ieb/autopilot/docs/model_architecture_evaluation.md

# Model Architecture Evaluation (Archived)

> **Archived**: This document contains early exploratory notes on a smaller model (48k params, 25 features) that failed in closed-loop testing. The current production system uses a 255k parameter model with 22 features, residual labels, and blended PD + ML inference. See **[blended_pd_ml_controller.md](blended_pd_ml_controller.md)** for the current architecture and validated results.

---

*Historical notes below:*

# Asked Google AI

WDYT about ....
━━━━━━━━━━━━━━━━━━━━━━━━━━━━━━━━━━━━━━┳━━━━━━━━━━━━━━━━━━━━━━━━━━━━━┳━━━━━━━━━━━━━━━━━┓
┃ Layer (type)                         ┃ Output Shape                ┃         Param # ┃
┡━━━━━━━━━━━━━━━━━━━━━━━━━━━━━━━━━━━━━━╇━━━━━━━━━━━━━━━━━━━━━━━━━━━━━╇━━━━━━━━━━━━━━━━━┩
│ sensor_sequence (InputLayer)         │ (None, 20, 25)              │               0 │
├──────────────────────────────────────┼─────────────────────────────┼─────────────────┤
│ feature_mixing (TimeDistributed)     │ (None, 20, 64)              │           1,664 │
├──────────────────────────────────────┼─────────────────────────────┼─────────────────┤
│ bn_feature (TimeDistributed)         │ (None, 20, 64)              │             256 │
├──────────────────────────────────────┼─────────────────────────────┼─────────────────┤
│ lstm_1 (LSTM)                        │ (None, 20, 64)              │          33,024 │
├──────────────────────────────────────┼─────────────────────────────┼─────────────────┤
│ dropout (Dropout)                    │ (None, 20, 64)              │               0 │
├──────────────────────────────────────┼─────────────────────────────┼─────────────────┤
│ lstm_2 (LSTM)                        │ (None, 32)                  │          12,416 │
├──────────────────────────────────────┼─────────────────────────────┼─────────────────┤
│ dropout_1 (Dropout)                  │ (None, 32)                  │               0 │
├──────────────────────────────────────┼─────────────────────────────┼─────────────────┤
│ dense_out (Dense)                    │ (None, 16)                  │             528 │
├──────────────────────────────────────┼─────────────────────────────┼─────────────────┤
│ bn_dense (BatchNormalization)        │ (None, 16)                  │              64 │
├──────────────────────────────────────┼─────────────────────────────┼─────────────────┤
│ rudder_command (Dense)               │ (None, 1)                   │              17 │
└──────────────────────────────────────┴─────────────────────────────┴─────────────────┘
 Total params: 47,969 (187.38 KB)
 Trainable params: 47,809 (186.75 KB)
 Non-trainable params: 160 (640.00 B)

INFO:__main__:Training on 539904 samples, validating on 134976

# Response was 

This model architecture is better structured than your initial attempts, especially for handling sequential sensor data. However, there is one significant bottleneck and a few refinement opportunities for 2026-era training.

1. The Output Layer "Squeeze" (Potential Issue)
The Issue: Your architecture flows from dense_out (16 units) → bn_dense → rudder_command (1 unit).

The Problem: You are applying Batch Normalization directly before your final regression output. In regression tasks, BN can sometimes "fight" the final output layer by forcing the distribution of the 16 hidden neurons to have a mean of 0 and variance of 1 right before you need to predict a specific, un-normalized value (like an angle in degrees).

Recommendation: If you find the model struggling to reach the exact values (e.g., sticking near 0°), move bn_dense to before the dense_out layer or remove it entirely. Batch Normalization is generally most effective deep in the network, not at the final exit. 

2. Feature Mixing Efficiency

The Setup: Using TimeDistributed(Dense(64)) before the LSTM is an excellent design pattern for "feature mixing" (combining 25 sensor inputs into 64 higher-level concepts per timestep).

Optimization: Since you have a large dataset (540k samples), you could likely increase the feature_mixing units to 128 or 256. With 25 input features, 64 is a safe starting point, but the model has enough data to learn more complex relationships. 

3. LSTM Bottleneck

The Setup: lstm_1 (64 units) → lstm_2 (32 units).
The Observation: You are aggressively shrinking the data representation from 64 to 32 units in the second LSTM.

Refinement: If the model's accuracy (MAE) plateaus, consider making lstm_2 larger (64 units) to match lstm_1. Usually, you only shrink the layer size if you are fighting severe overfitting. 

4. Dropout Placement

Best Practice: In 2026, it is widely recommended to place Dropout after the activation but before the next layer. Your current placement after the LSTMs is standard and correct.

Check: Ensure you are using recurrent_dropout inside the LSTM layers if you have long-term temporal dependencies you want to regularize specifically. 

Summary Checklist
Monitor the Final BN: If training is slow to converge on the final degree value, disable bn_dense.

Learning Rate: Given your previous experience, start this run at 1e-4 and use the same ReduceLROnPlateau strategy you perfected earlier.

Trainability: 47,969 parameters for 540,000 samples is a very "lean" model. It is highly unlikely to overfit, so you may eventually find you can afford to double the layer sizes (e.g., 128 → 64 units) if the error isn't low enough. 

# Asked for clarification on "lean"

# Got

In machine learning, the relationship between the number of parameters (the model's "brain" size) and the number of samples (the amount of "experience" it has) determines how well the model learns.
Here is the significance of your "lean" model:
1. High "Data-to-Parameter" Ratio
You have 540,000 samples but only 48,000 parameters. This means the model has roughly 11 samples of information to help it decide the value of every 1 single parameter.

The Benefit: This makes the model very "honest." Because it has so little "brain space" compared to the massive amount of data, it cannot afford to "memorize" specific rows of data (overfitting). It is forced to learn the broad, general rules of how the sensors affect the rudder.

The Result: Your Validation Loss will likely stay very close to your Training Loss. The model will be very stable when you deploy it in the real world.

2. The Risk of "Underfitting"
The downside of a "lean" model is that it might be too simple.

Think of it like trying to write a complex physics textbook using only a 100-word vocabulary. You can get the general idea across, but you might miss the precise details.

If your MAE (Mean Absolute Error) stops improving at a value that is still too high (e.g., it gets stuck at 1.5° but you need 0.5°), it means the model is "full." It doesn't have enough parameters to store the complex mathematical relationships hidden in the data.

3. What "Affording to Double" means
When I say you can "afford" to increase the layer sizes, I mean you have a massive "budget" of data.

Usually, when people make models bigger (e.g., changing 64 units to 128 units), they worry the model will start overfitting because it has more "room" to memorize noise.

However, because you have half a million samples, you could triple the size of this model (moving to ~150,000 parameters) and you still wouldn't have enough room to overfit.

Summary

Current status: Your model is "Skinny and Efficient." It will be very fast and very reliable, but it might hit a "ceiling" in how accurate it can get.

If the error is too high: Increase your LSTM units (e.g., from 64 to 128). This gives the model a "larger vocabulary" to describe the sensor-to-rudder relationship.

If the error is already good enough: Don't change a thing. A lean model is always better for real-time performance (like controlling a rudder).

# What I think.

Good. I dont need a great deal of precision. +- 1 degree of rudder is probably ok since the output will be updated ever 0.1s so provided the overall view is correct then being roughly honest is great. That said, I might look at a longer time prediction and use the extra space that way.
