ieb/autopilot/hardware/actuator-board/actuator-board.kicad_pcb

## KiCad design hardware/actuator-board/actuator-board.kicad_pcb (2026-02-01)

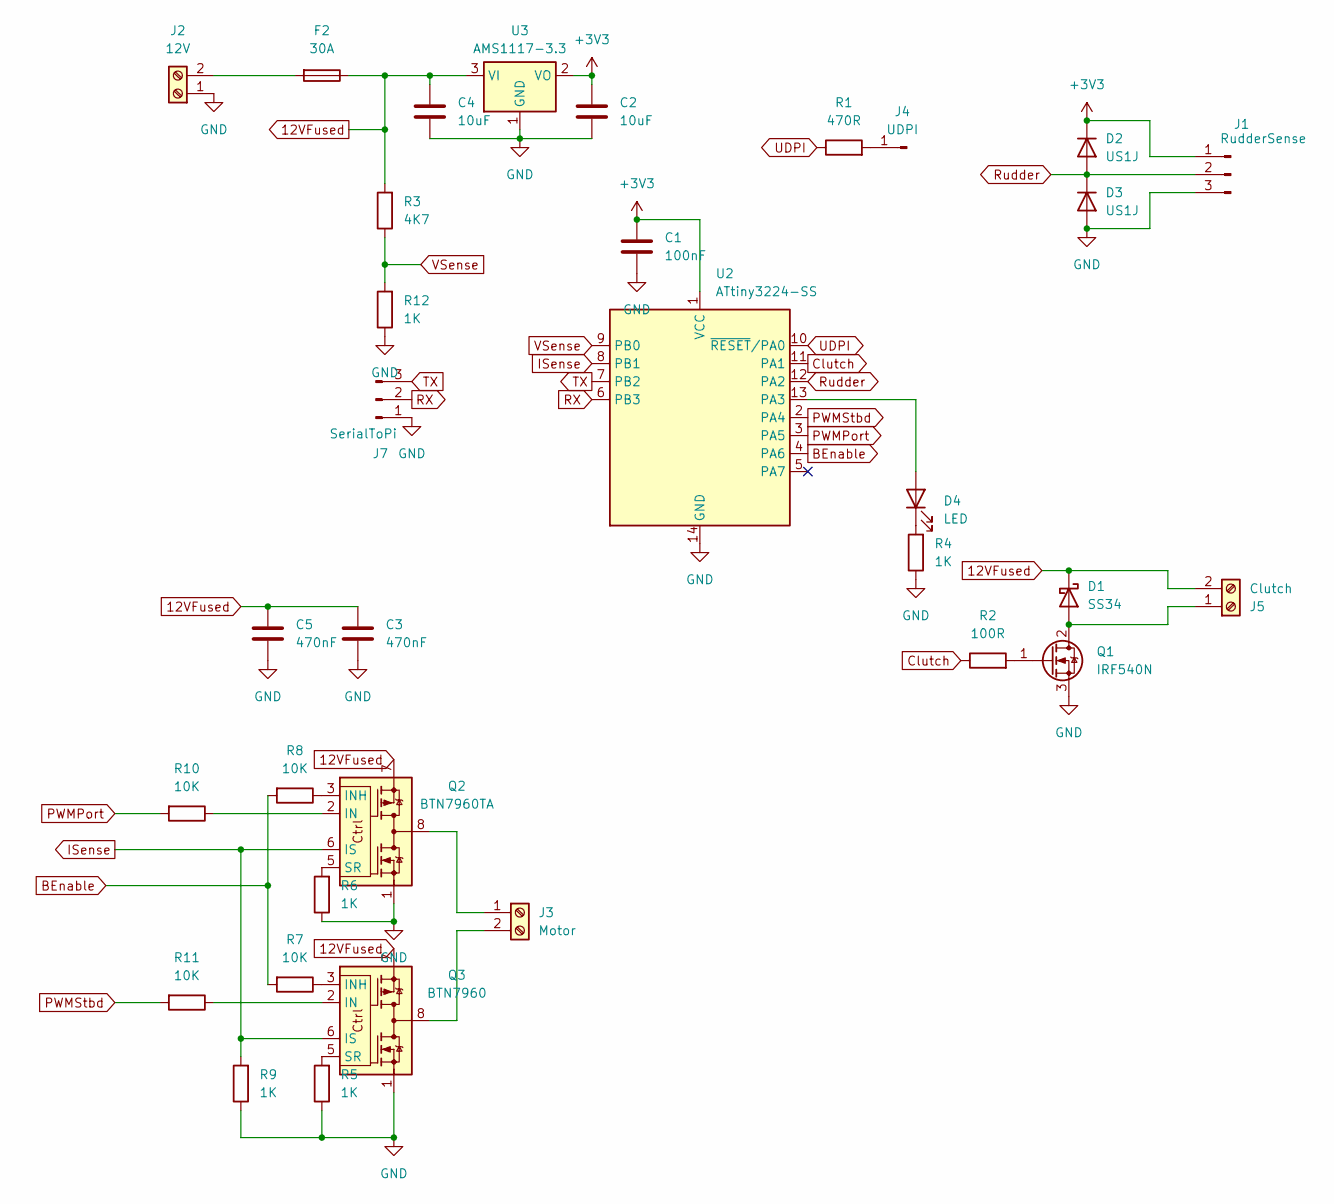
[picture p1: schematic actuator-board.kicad_sch, Actuator Controller Board]

Parts:
C1: 100nF; C_0805_2012Metric
C2, C4: 10uF; C_0805_2012Metric
C3, C5: 470nF; C_0805_2012Metric
D1: SS34; D_SMA
D2, D3: US1J; D_SMA
D4: LED; C_0805_2012Metric
F2: 30A; Fuse_Blade_ATO_directSolder
J1: RudderSense; TerminalBlock_Phoenix_MPT-0,5-3-2.54_1x03_P2.54mm_Horizontal
J2: 12V; TerminalBlock_Phoenix_MKDS-1,5-2-5.08_1x02_P5.08mm_Horizont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
J3: Motor; TerminalBlock_Phoenix_MKDS-1,5-2-5.08_1x02_P5.08mm_Horizont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
J4: UDPI; PinHeader_1x01_P1.00mm_Vertical
J5: Clutch; TerminalBlock_Phoenix_MPT-0,5-2-2.54_1x02_P2.54mm_Horizontal
J7: SerialToPi; JST_XH_B3B-XH-AM_1x03_P2.50mm_Vertical
Q1: IRF540N; TO-220-3_Vertical
Q2: BTN7960TA; TO-263-7_TabPin8
Q3: BTN7960; TO-263-7_TabPin8
R1: 470R; R_0805_2012Metric
R2: 100R; R_0805_2012Metric
R3: 4K7; R_0805_2012Metric
R4, R5, R6, R9, R12: 1K; R_0805_2012Metric
R7, R8, R10, R11: 10K; R_0805_2012Metric
U2: ATtiny3224-SS; SOIC-14_3.9x8.7mm_P1.27mm
U3: AMS1117-3.3; SOT-223-3_TabPin2

Connections:
12VFused: C3.1, C4.1, C5.1, D1.1 (K), F2.1, J5.2, Q2.7, Q3.7, R3.2, U3.3 (VI)
+3V3: C1.1, C2.1, D2.1 (K), J1.1, U2.1 (VCC), U3.2 (VO)
BEnable: R7.2, R8.2, U2.4 (PA6)
Clutch: R2.1, U2.11 (PA1)
GND: C1.2, C2.2, C3.2, C4.2, C5.2, D3.2 (A), J1.3, J2.1, J7.1, Q1.3 (S), Q2.1, Q3.1, R4.1, R5.1, R6.1, R9.1, R12.1, U2.14 (GND), U3.1 (GND)
ISense: Q2.6 (IS), Q3.6 (IS), R9.2, U2.8 (PB1)
unnamed: D1.2 (A), J5.1, Q1.2 (D)
unnamed: D4.2 (A), U2.13 (PA3)
unnamed: D4.1 (K), R4.2
unnamed: F2.2, J2.2
unnamed: J3.1, Q2.4, Q2.8
unnamed: J3.2, Q3.4, Q3.8
unnamed: J4.1, R1.2
unnamed: Q1.1 (G), R2.2
unnamed: Q2.2 (IN), R10.1
unnamed: Q2.3 (INH), R8.1
unnamed: Q2.5 (SR), R6.2
unnamed: Q3.2 (IN), R11.1
unnamed: Q3.3 (INH), R7.1
unnamed: Q3.5 (SR), R5.2
PWMPort: R10.2, U2.3 (PA5)
PWMStbd: R11.2, U2.2 (PA4)
RX: J7.2, U2.6 (PB3)
Rudder: D2.2 (A), D3.1 (K), J1.2, U2.12 (PA2)
TX: J7.3, U2.7 (PB2)
UDPI: R1.1, U2.10 (~RESET/PA0)
VSense: R3.1, R12.2, U2.9 (PB0)

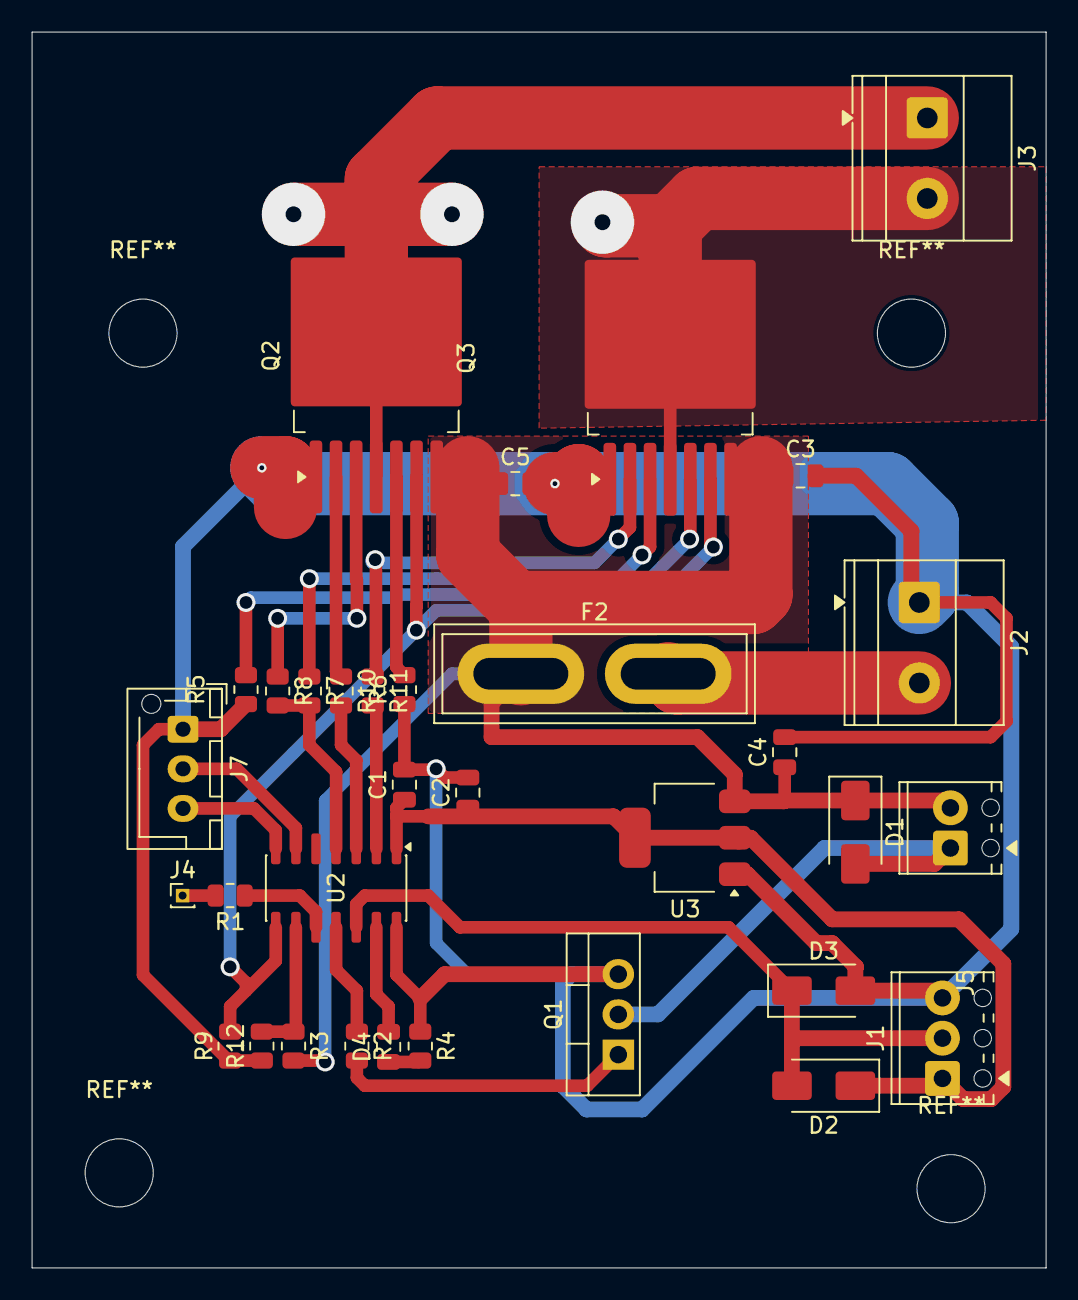
[picture p2: board actuator-board.kicad_pcb from above]

Board: 2 copper layers, 64.0 x 78.0 mm, 33 parts (0 on the bottom side), 27 nets.
