ieb/autopilot/(commit log)

2026-01-19 First pass at the hardware, needs checking in KiCad as Claud might have made a mess
    [BOM.csv, imu-board.kicad_pcb, imu-board.kicad_sch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]
2026-01-20 Adjusted design to move actuator to dedicated controller
    [BOM.csv, imu-board.kicad_pcb, imu-board.kicad_sch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]
2026-01-20 Updated hardware and firmware to match new design
    [BOM.csv, actuator-board.kicad_sch, imu-board.kicad_sch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]
2026-01-23 Harware designs, and log analysis
    [BOM.csv, actuator-board.kicad_sch, imu-board.kicad_pcb, imu-board.kicad_sch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]
2026-01-24 Bump wheel from 0.45.1 to 0.46.2
    Bumps [wheel](https://github.com/pypa/wheel) from 0.45.1 to 0.46.2.
    - [Release notes](https://github.com/pypa/wheel/releases)
    - [Changelog](https://github.com/pypa/wheel/blob/main/docs/news.rst)
    - [Commits](https://github.com/pypa/wheel/compare/0.45.1...0.46.2)
    ---
    updated-dependencies:
    - dependency-name: wheel
    dependency-version: 0.46.2
    dependency-type: indirect
    ...
2026-01-25 Fixed traning data generation
    [regenerate_training_data.py]
2026-01-25 Fixed bug found in helm controller messing up training data
    [test_experiment1.py, test_simulation.py]
2026-01-25 Fixed, hopefully rudder conventions causing bad behaviour
    [adc_reader.py, data_loader.py, rudder_controller.py]
2026-01-25 Conventions were not being followed, added rule and fixed
    [data_loader.py, regenerate_training_data.py, test_autopilot_model.py]
2026-02-01 Added hardware design for actuator board
    [actuator-board.kicad_pcb, actuator-board.kicad_sch]
2026-02-01 added docs for offset imu support
2026-02-01 Modified IMU firmware and controller to operate in a simplex mode
2026-02-02 Added an i2c IMU implementation
2026-02-07 added i2c imu for bno055, and introduced boat wave physics
2026-02-08 Python 13.1 required.
    PiOS only has Python 13, and downgrading requires building python from source,
    so have dropped Tensorflow that was forcing a dependency on 11 due to GPU support
    on Apple silicon for traning and switched to PyTorch which works on all versions of
    Python and appears to have become the standard. This mostly impacts training
    the model as the Onnx runtime on the Pi remains unchanged. Unfortunately there is
    no way of targetting platform spefific python versions in pyproject.toml, and
    there is a long term risk of targgeting a specific version or python given the very
    limits Python version support in PiOS distributions. Deadsnakes is ubuntu based and does
    not support Debian base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
2026-02-08 Added scripts for testing an imu
2026-02-09 Verified IMU performance on a Pi 1 B+
2026-02-09 Added IMU visualisation and control app, still needs some work to fix the orientation
2026-02-09 Fixed imu monitoring app
2026-02-12 Fixed calibration settings
2026-03-04 Added new can logger, a pd adn pid pilot, deployment and fixed some bugs.
    [base.py, can_logger.py, can_logger_web.py]
2026-03-06 Add ESP32-S3 consolidated autopilot firmware
    Single-board PlatformIO project replacing Pi + ATtiny3224 + ATtiny3226.
    Combines IMU fusion (BNO055), NMEA2000 (TWAI), PD/PID/Smooth/Adaptive
    pilots, actuator control (BTS7960), polar/VMG, and web config UI.
    Uses ieb/NMEA2000_twai for ESP32-S3 TWAI CAN bus support.
    ESP32-S3 build compiles (870KB flash, 45KB RAM).
    24 native unit tests pass (pilots + polar + sign conventions).
2026-03-06 added a bunch of missing files
    [actuator_sim.py, data_loader.py]
2026-03-10 Created native (macOS) simulation for the ESP32 firmware to allow more complete validation of behaviour
2026-03-15 Fixed GPS Time reporting in the logger
    [can_logger.py, test_can_logger.py]
2026-03-18 fix reported path problems
    [test_vis_server.py]
